ChevanR/ACM/Prototypes.pdf

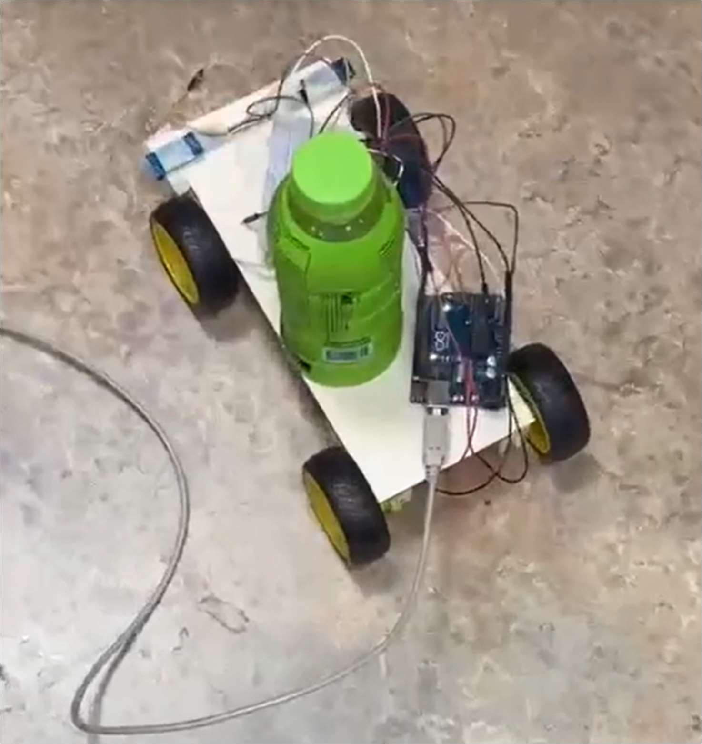
[picture p2: figure]

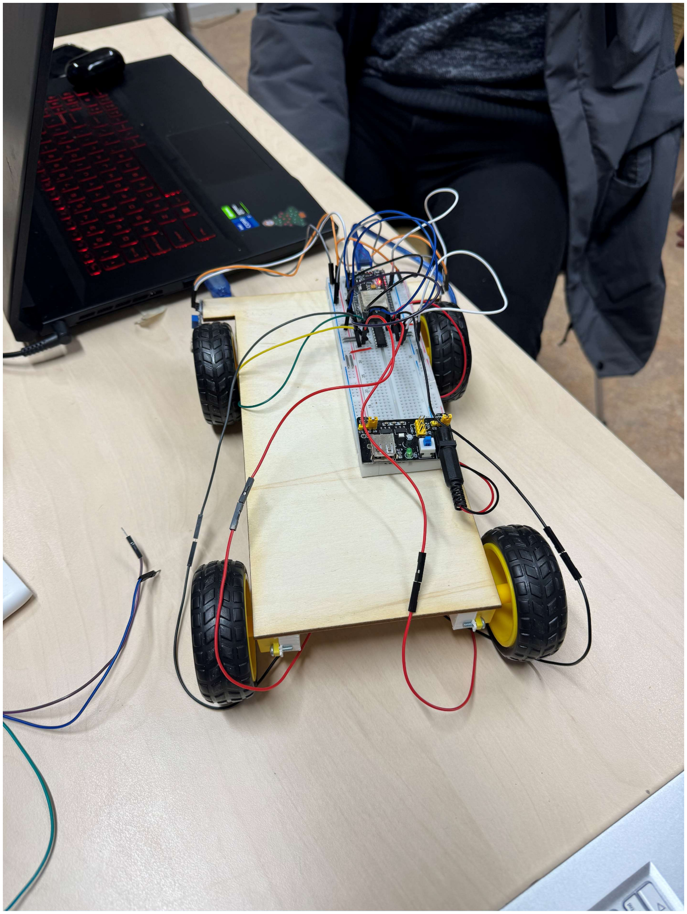
[picture p3: figure]
