ChevanR/ACM/Elektrisch schema.png

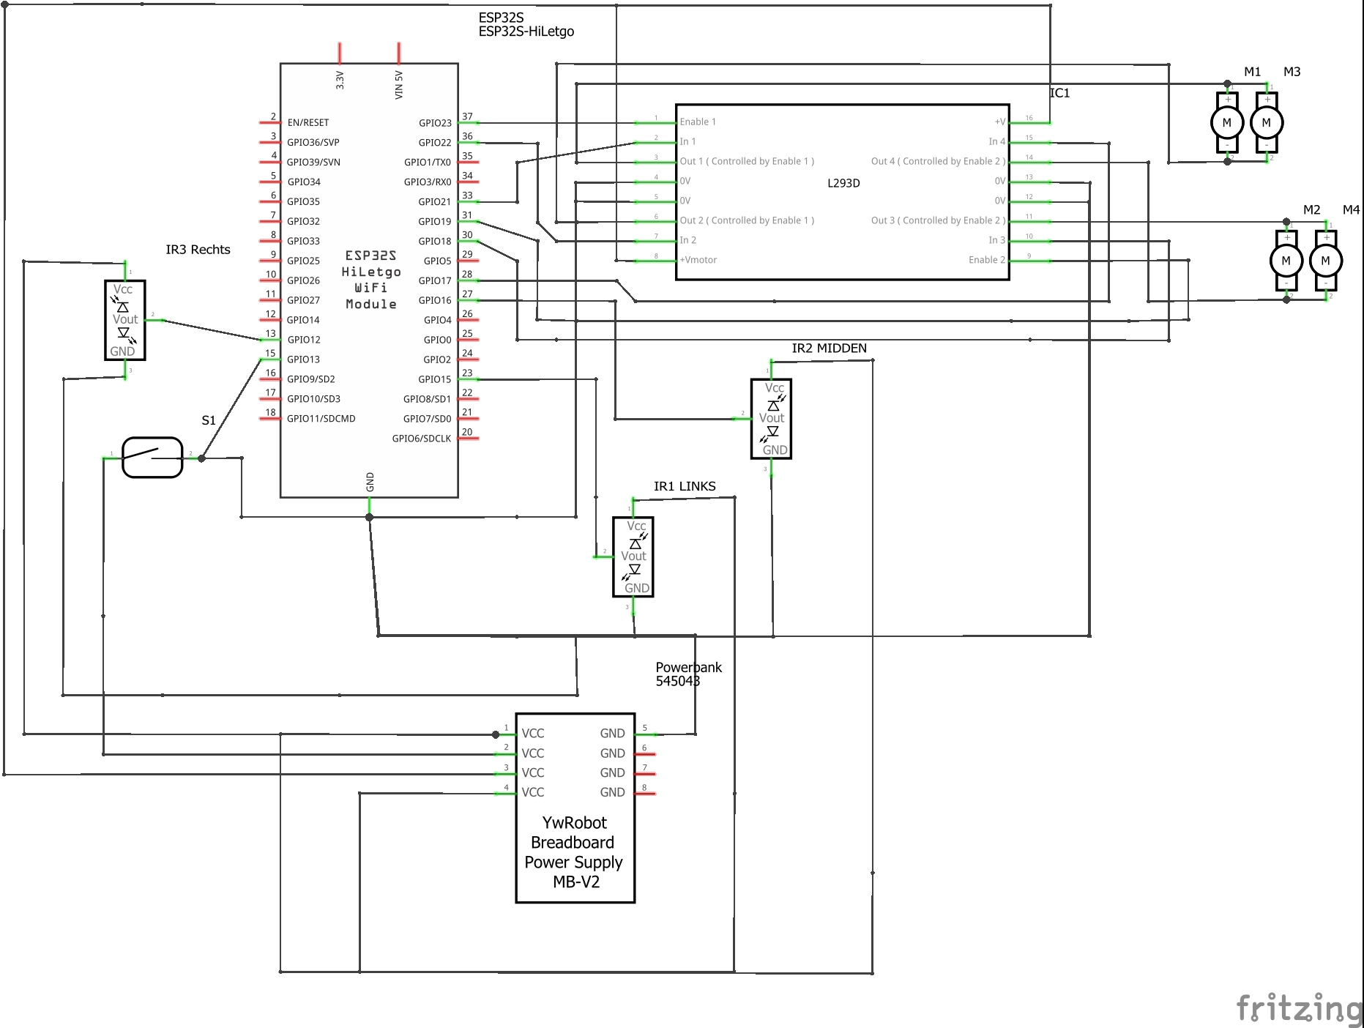
Elektrisch schema.png
