ChevanR/ACM/ACM Groep 3.pdf

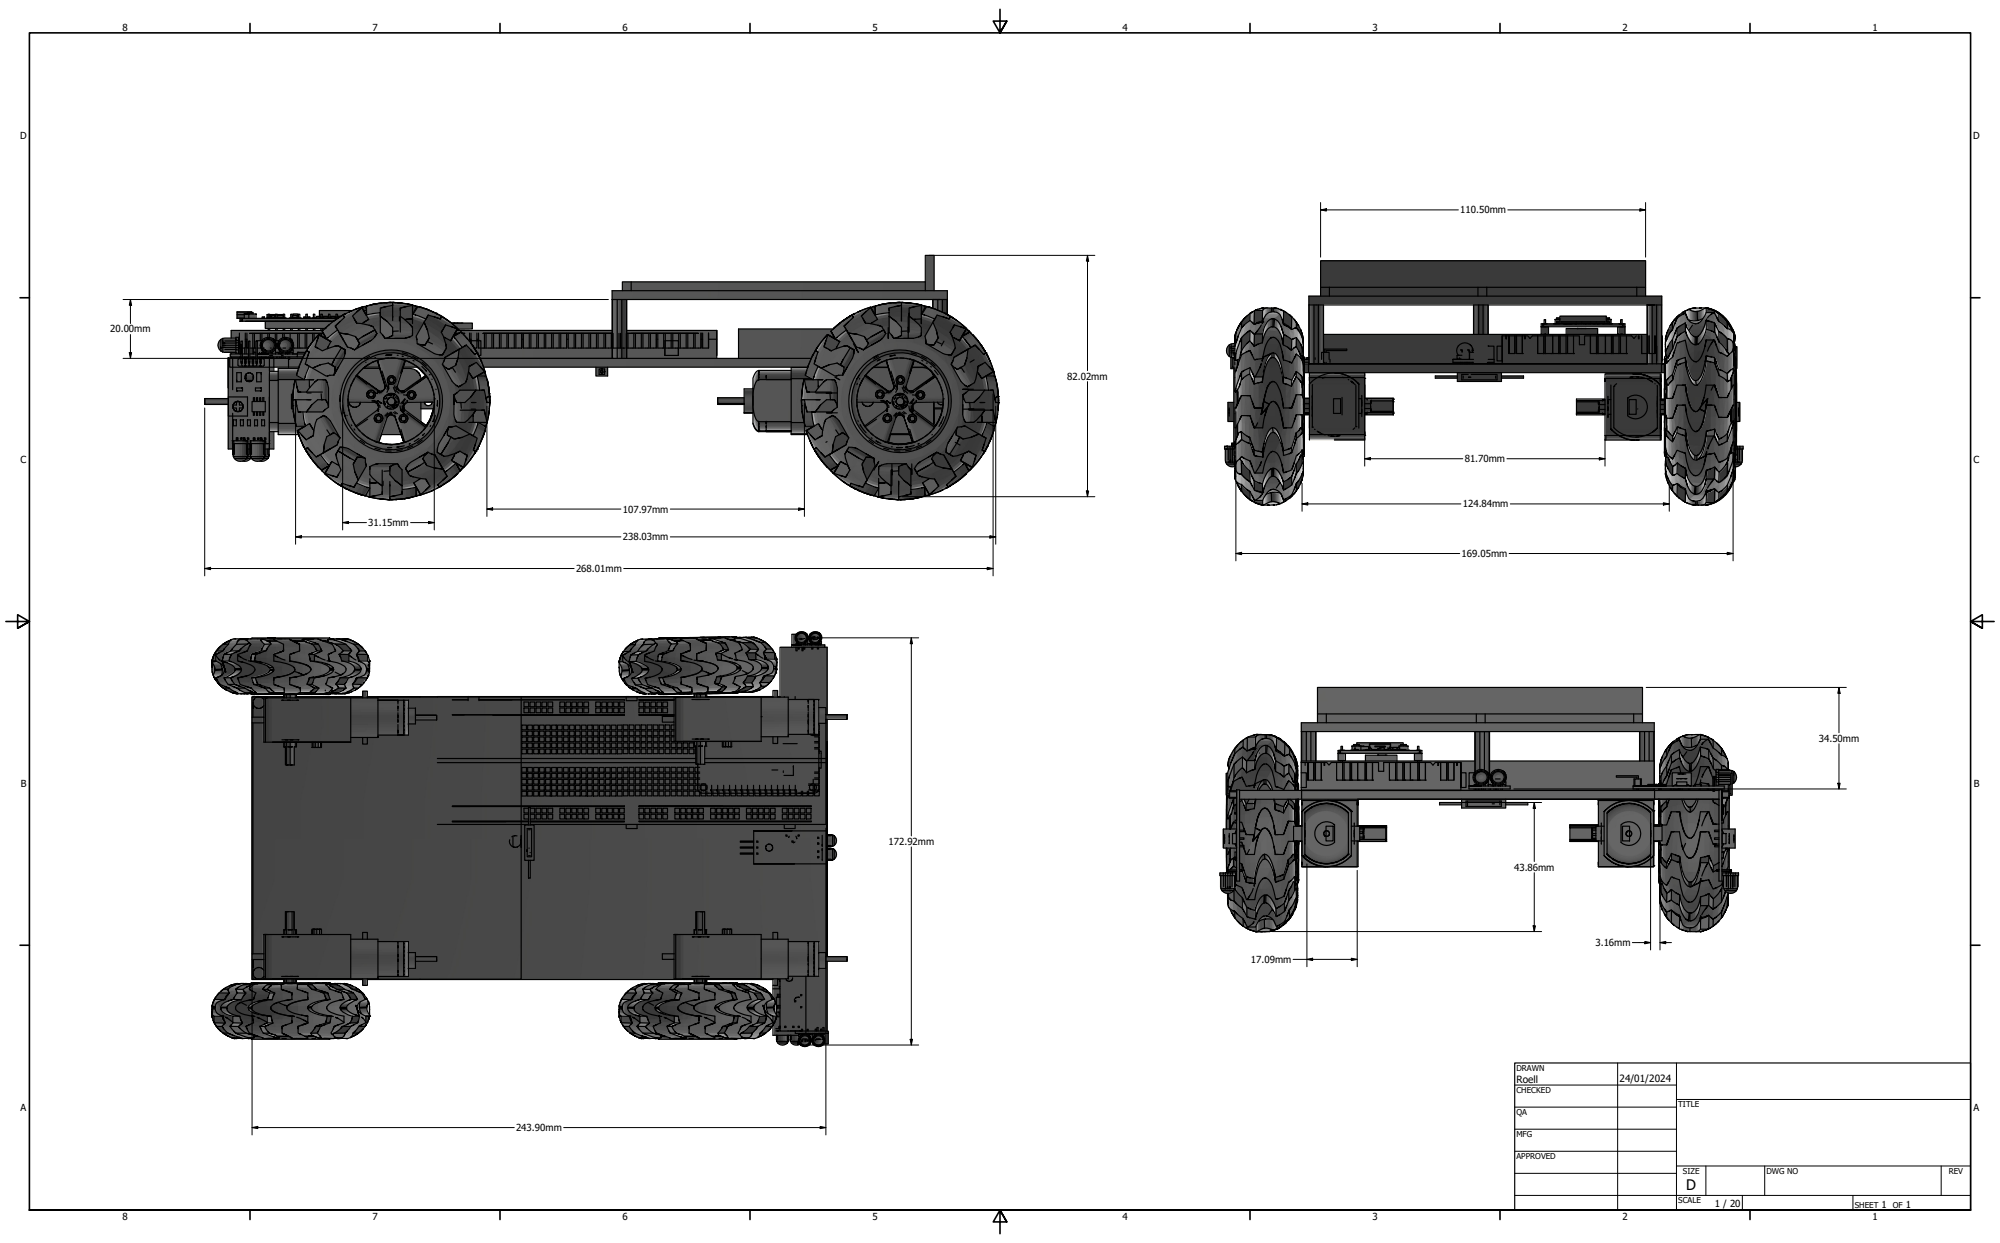
[picture p5: page 1]
SHEET 1 OF 1; DWG NO
