ChevanR/ACM/Flowchart ACM Groep 3 1.pdf

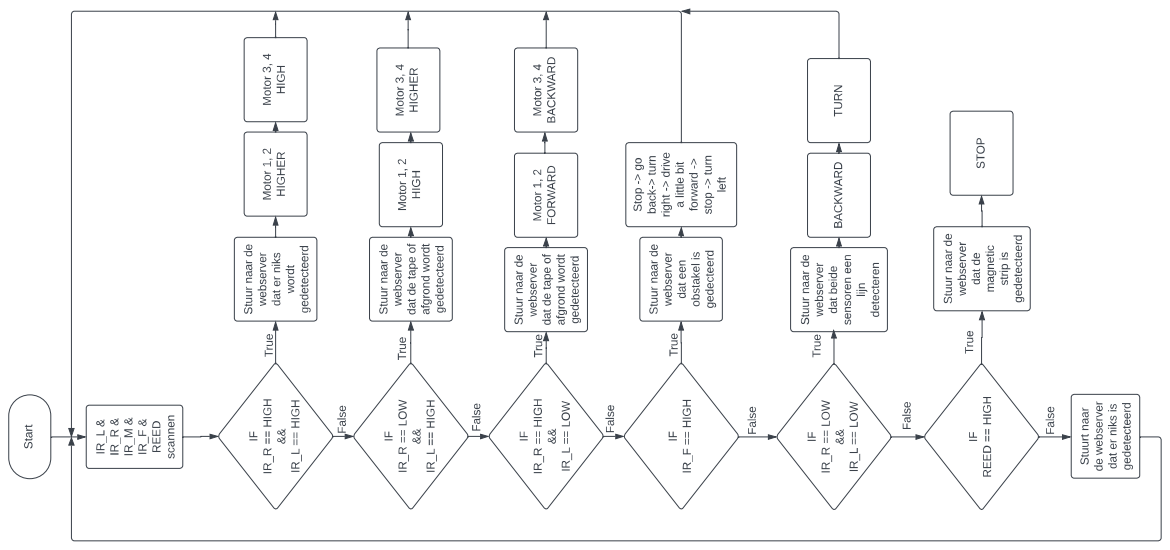
[picture p6: page 1]
